Mrarthurking95/Sumobotmini/Link.txt

https://github.com/Mrarthurking95/Sumobotmini.git
