Mrarthurking95/Sumobotmini/Anexos/Costos.xlsx

Elemento | Referencia | Cantidad | Precio unidad | Precio total
Micro motor | HPCB 50:1/1.1 kg-cm/625rpm | 2 | $56000.00 | $112000.00
Sensor infrarrojo | Sensor Infrarrojo Sharp Análogo (4-30cm) | 3 | $25000.00 | $75000.00
Soporte | Soporte para micro motor | 2 | $15000.00 | $15000.00
Sensor Infrarrojo | Sensor Infrarrojo QRD1114 | 4 | $3200.00 | $12000.00
Rueda | Rueda Mini Sumo | 2 | $35000.00 | $35000.00
Batería | Batería Lipo | 1 | $51979.00 | $51979.00
Driver De Motor | Driver De Motor L293D | 1 | $4000.00 | $4000.00
Micro controlador | STM32F103C8T6 (Blue Pill) | 1 | $18500.00 | $18500.00
Módulo Wifi | Módulo Wifi - ESP8266 | 1 | $9000.00 | $9000.00
Regulador | AMS1117 | 1 | $2300.00 | $4600.00
Regulador | Lm7805 TO-220 | 1 | $1500.00 | $1500.00
Resistencia | Resistencias ¼ W | 11 | $20.00 | $220.00
Capacitores | Condensador electrolítico de montaje | 5 | $100.00 | $500.00
Diodo Zener | Diodo Zener DO-41 (DO-204AL) de 3.6V | 1 | $200.00 | $200.00
Bornera | Bornera 2 pines | 3 | $600.00 | $1800.00
Placa | Placa de cobre | 1 | $1500.00 | $1500.00
Pulsador | Pulsador NA, tipo Through-hole-mounting. | 1 | $200.00 | $200.00
Switch | Interruptor de encendido / apagado | 1 | $2000.00 | $2000.00
Costo total |  |  |  | $344999.00
