Mrarthurking95/Sumobotmini/PCB/Project Outputs for PCB_Project/pcbsumo.xls

Comment | Description | Designator | Footprint | LibRef | Quantity
BLUE PILL | DIP20 STM32F103C8T6 |  | DIP40 | BLUE PILL | 1
L293D | TB6612FNG |  | DIP16 | L293D | 1
BORNERA1X2 | Optoacoplador con fototransistor de salida y conexión a base. Voltaje de aislamiento de prueba 5300 VRMS, capacitancia entrada -salida < 0.5 pF. Empaque 6-DIP. | BAT7.4, MOT1, MOT2 | BORN1X2 | BORNERA1X2 | 3
Cap2 | Capacitor | C1, C2, C3, C4 | CAPR5-4X5 | Cap2 | 4
D Zener | Zener Diode | D1 | DIODE-0.7 | D Zener | 1
LM7805 | D39 IC REGULATOR 5VOLT LM7805 THT | P1 | TO-220A | LM7805 | 1
Pulsador2 |  | pul1 | PULSADOR | Pulsador2 | 1
Connector header 4P | Header, 4-Pin | QRD1114_1, QRD1114_2, QRD1114_3, QRD1114_4 | HEADER 1X4 | Connector header 4P | 4
Res1 | Resistor | R1, R2, R3, R4, R5, R6, R7, R8, R9, R10, R12 | AXIAL-0.3 | Res1 | 11
SW-PB | Switch | S1 | SPST-2 | SW-PB | 1
Connector header 3P | Header, 3-Pin | SHARP1, SHARP2, SHARP3 | HEADER 1X3 | Connector header 3P | 3
Mod regu 3.3 | Optoacoplador con fototransistor de salida y conexión a base. Voltaje de aislamiento de prueba 5300 VRMS, capacitancia entrada -salida < 0.5 pF. Empaque 6-DIP. | U1 | ASM1117 | ASM1117 | 1
