Mrarthurking95/Sumobotmini/Anexos/Schematic Prints.pdf

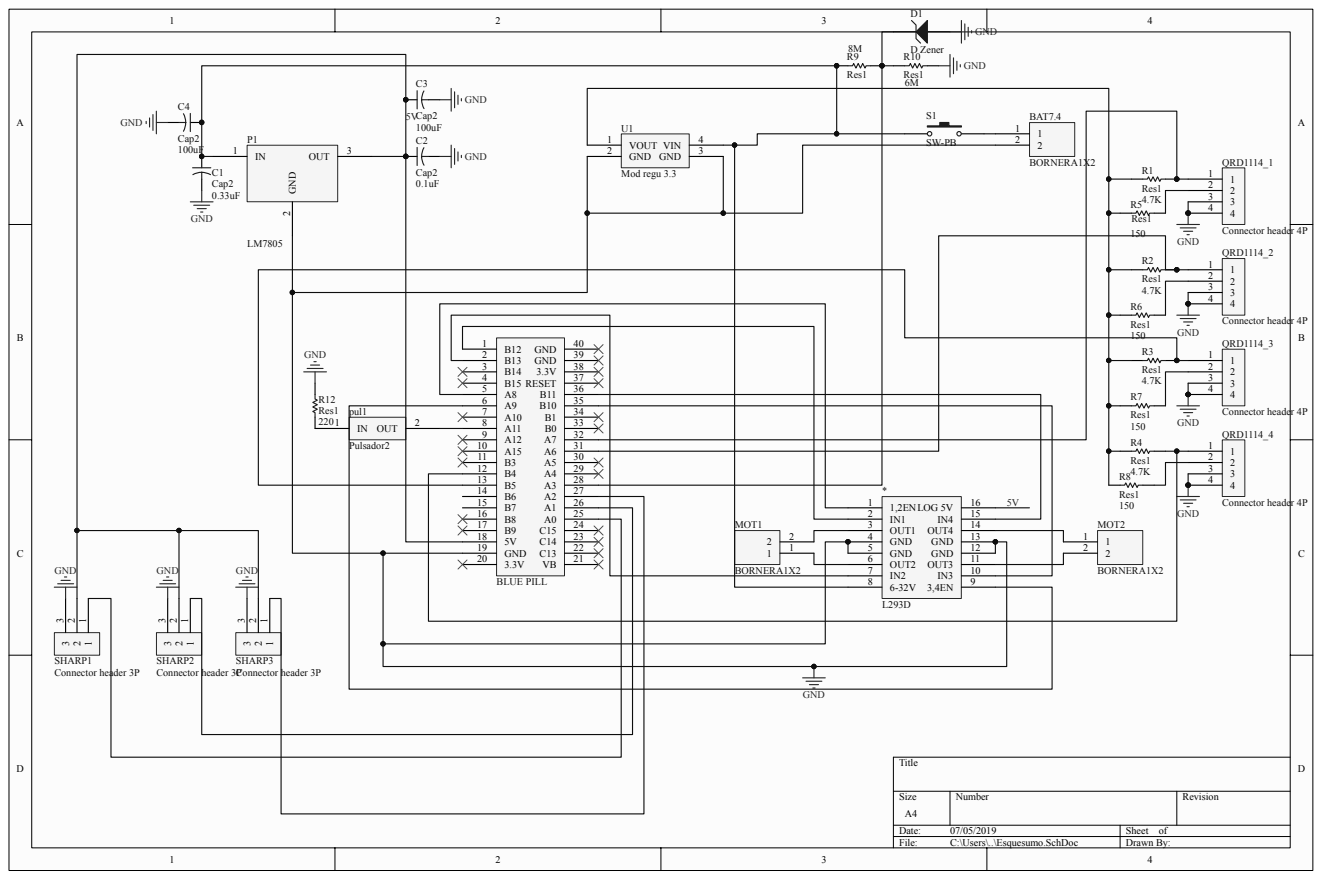
[picture p21: page 1]

8M D Zener R9

Size A4 | Number | Revision

Date: 07/05/2019 | Sheet of
File: C:\Users\..\Esquesumo.SchDoc | Drawn By:
