Mrarthurking95/Sumobotmini/(list of files, drawings)

Other design files:
PCB/Biblioteca/Biblioteca esquematica.SchLib
PCB/Biblioteca/Bibliotecahpta.PcbLib
PCB/Biblioteca/Esquesumo.SchDoc
PCB/PCB_Project.PrjPcb
PCB/pcbsumo.PcbDoc
