Mrarthurking95/Sumobotmini/Sumov1/Src/main.c

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

/* Includes ------------------------------------------------------------------*/
#include "main.h"

/* USER CODE BEGIN PD */
volatile uint16_t contMilis=0;
volatile uint16_t contAttack=0;//Tiempo de ataque
volatile uint16_t sharpizq;//Sensor ir sharp de frente
volatile uint16_t sharpfront;//Sensor ir sharp de frente
volatile uint16_t sharpder;//Sensor ir sharp de frente
volatile uint16_t battery;//Adc voltaje bateria
volatile uint8_t QRD1;
volatile uint8_t QRD2;
volatile uint8_t QRD3;
volatile uint8_t QRD4;
//volatile uint8_t tadcEN;
void direccion_process();//proceso direccion
void modo_process();//proceso modo
void piso_process();//proceso el piso
enum{//Estados motores
	   ADELANTE=0,
	   ATRAS,
	   IZQUIERDA,
	   DERECHA,
	   QUIETO,
	   DIRSTAT//Numero de Timers boton presionado
};
ST_MOT=ADELANTE;
enum{//Timers de estado
	TimATAQUE,
	TimREVERSA,
	TIMERS
};
ST_TIM=TimATAQUE;
enum{//Modo robot
	BUSQUEDA=0,
	ATAQUE,
	FREERUN,//Modo de camino random
	DESCANSO,
	ESTAT//Numero de estados
}
ST_MODO=DESCANSO;
/* USER CODE END PD */

ADC_HandleTypeDef hadc1;
DMA_HandleTypeDef hdma_adc1;
TIM_HandleTypeDef htim1;
TIM_HandleTypeDef htim2;
UART_HandleTypeDef huart1;
/* USER CODE BEGIN PV */
uint16_t alistarse=0;
uint8_t alistEN=0;
uint8_t TiemADC=0;
uint8_t atimEN=0;//Timer que define el tiempo que durara en la secuencia de ataque
volatile uint32_t adc_buf[4];
/* USER CODE END PV */

void SystemClock_Config(void);
static void MX_GPIO_Init(void);
static void MX_DMA_Init(void);
static void MX_TIM1_Init(void);
static void MX_TIM2_Init(void);
static void MX_ADC1_Init(void);
static void MX_USART1_UART_Init(void);
/**
  * @brief  The application entry point.
  * @retval int
  */
int main(void)
{
  /* MCU Configuration--------------------------------------------------------*/

  /* Reset of all peripherals, Initializes the Flash interface and the Systick. */
  HAL_Init();

  /* Configure the system clock */
  SystemClock_Config();

  /* Initialize all configured peripherals */
  MX_GPIO_Init();
  MX_DMA_Init();
  MX_TIM1_Init();
  MX_TIM2_Init();
  MX_ADC1_Init();
  MX_USART1_UART_Init();
  /* USER CODE BEGIN 2 */
  HAL_TIM_Base_Start_IT(&htim2);
  HAL_ADC_Start_DMA(&hadc1,(uint32_t*)adc_buf,4);
  HAL_ADC_Start_IT(&hadc1);
  HAL_TIM_PWM_Start(&htim1,TIM_CHANNEL_1);
  HAL_TIM_PWM_Start(&htim1,TIM_CHANNEL_2);
  __HAL_TIM_SET_COMPARE(&htim1,TIM_CHANNEL_1,3599);//100%
  __HAL_TIM_SET_COMPARE(&htim1,TIM_CHANNEL_2,3599);//100%
  /* USER CODE END 2 */

  /* Infinite loop */
  /* USER CODE BEGIN WHILE */
  while (1)
  {
    /* USER CODE END WHILE */

    /* USER CODE BEGIN 3 */
	  //Inicio cambio segundo
	  /*
	  HAL_ADC_Start(&hadc1);
	  HAL_ADC_PollForConversion(&hadc1,15);//15 ms muestreo
	  sharpfront=HAL_ADC_GetValue(&hadc1);
	  HAL_ADC_Stop(&hadc1);
	  */
	  //Adc para sensores
	  if(TiemADC>=10){
		  HAL_ADC_Start_IT(&hadc1);
		  sharpizq=adc_buf[0];
		  sharpfront=adc_buf[1];
		  sharpder=adc_buf[2];
		  battery=adc_buf[3];
		  TiemADC=0;
	  }else{
		//  tadcEN=1;
	  }
	  modo_process();
	  direccion_process();
  }
  /* USER CODE END 3 */
}
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
/* USER CODE BEGIN 4 */
void modo_process(){
	switch(ST_MODO){
	case BUSQUEDA:
		if(sharpizq<sharpfront && sharpfront>sharpder){ //Objeto en el frente mayor
		//	ST_MODO=ATAQUE;
			  ST_MOT=ADELANTE;
		}else if(sharpizq>sharpfront && sharpizq>sharpder){//Si hay un objeto en izquierda
		    ST_MOT=IZQUIERDA;
		}else if(sharpder>sharpfront && sharpder>sharpizq){
			ST_MOT=DERECHA;
		}
		alistarse=0;
//		ST_MOT=IZQUIERDA;
	break;
	case ATAQUE:
		atimEN=1;//attack timer enable
		ST_MOT=ADELANTE;//Modo ataque
		if(contAttack>=2500){
			atimEN=0;
			contAttack=0;
			ST_MOT=BUSQUEDA;
		}

	break;
	case FREERUN:
		  if(contMilis>=1000){//Programacion freerun
			  contMilis=0;
			  HAL_GPIO_TogglePin(GPIOC,GPIO_PIN_13);
			  if(ST_MOT==ADELANTE){
				  ST_MOT=ATRAS;
			  }
			  else if(ST_MOT==ATRAS){
				  ST_MOT=IZQUIERDA;
			  }
			  else if(ST_MOT==IZQUIERDA){
				  ST_MOT=DERECHA;
			  }
			  else if(ST_MOT==DERECHA){
				  ST_MOT=QUIETO;
			  }
			  else if(ST_MOT==QUIETO){
				  ST_MOT=ADELANTE;
			  }
			  contMilis=0;
		  } //Fin programacion freerun
	break;
	case DESCANSO://5 segundos antes de la competicion
		ST_MOT=QUIETO;
		if(alistarse>=5000){
			ST_MODO=BUSQUEDA;
		}
	break;
	}
}//Fin modos del carro
void piso_process(){
	QRD1=HAL_GPIO_ReadPin(GPIOB,QRD1_Pin);//QRD1
	QRD2=HAL_GPIO_ReadPin(GPIOB,QRD2_Pin);//QRD2
	QRD3=HAL_GPIO_ReadPin(GPIOB,QRD3_Pin);//QRD3
	QRD4=HAL_GPIO_ReadPin(GPIOB,QRD4_Pin);//QRD4
}//Fin proceso piso
void direccion_process(){
switch(ST_MOT){
	case ADELANTE:
		  HAL_GPIO_WritePin(GPIOB,IN1_Pin, GPIO_PIN_RESET);//	B12
		  HAL_GPIO_WritePin(GPIOB, IN2_Pin, GPIO_PIN_SET);//B13
		  HAL_GPIO_WritePin(GPIOB,IN3_Pin, GPIO_PIN_SET);//	B12
		  HAL_GPIO_WritePin(GPIOB, IN4_Pin, GPIO_PIN_RESET);//B13
	break;
	case ATRAS:
		  HAL_GPIO_WritePin(GPIOB,IN1_Pin, GPIO_PIN_SET);//	B12
		  HAL_GPIO_WritePin(GPIOB, IN2_Pin, GPIO_PIN_RESET);//B13
		  HAL_GPIO_WritePin(GPIOB,IN3_Pin, GPIO_PIN_RESET);//	B12
		  HAL_GPIO_WritePin(GPIOB, IN4_Pin, GPIO_PIN_SET);//B13
	break;
	case IZQUIERDA:
		  HAL_GPIO_WritePin(GPIOB,IN1_Pin, GPIO_PIN_SET);//	B12
		  HAL_GPIO_WritePin(GPIOB, IN2_Pin, GPIO_PIN_RESET);//B13
		  HAL_GPIO_WritePin(GPIOB,IN3_Pin, GPIO_PIN_SET);//	B10
		  HAL_GPIO_WritePin(GPIOB, IN4_Pin, GPIO_PIN_RESET);//B11
	break;
	case DERECHA:
		  HAL_GPIO_WritePin(GPIOB,IN1_Pin, GPIO_PIN_RESET);//	B12
		  HAL_GPIO_WritePin(GPIOB, IN2_Pin, GPIO_PIN_SET);//B13
		  HAL_GPIO_WritePin(GPIOB,IN3_Pin, GPIO_PIN_RESET);//	B10
		  HAL_GPIO_WritePin(GPIOB, IN4_Pin, GPIO_PIN_SET);//B11
	break;
	case QUIETO:
		  HAL_GPIO_WritePin(GPIOB,IN1_Pin, GPIO_PIN_RESET);//	B12
		  HAL_GPIO_WritePin(GPIOB, IN2_Pin, GPIO_PIN_RESET);//B13
		  HAL_GPIO_WritePin(GPIOB,IN3_Pin, GPIO_PIN_RESET);//	B12
		  HAL_GPIO_WritePin(GPIOB, IN4_Pin, GPIO_PIN_RESET);//B13
	break;
}
}
void HAL_ADC_ConvCpltCallback(ADC_HandleTypeDef* hadc){//Interrupcion adc
	uint32_t val[4];
	if(hadc->Instance==ADC1){
		val[0]=adc_buf[0];
		val[1]=adc_buf[1];
		val[2]=adc_buf[2];
		val[3]=adc_buf[3];
	}
}
//Contador milis
void HAL_TIM_PeriodElapsedCallback(TIM_HandleTypeDef *htim){
	if(htim->Instance == TIM2){
		if(atimEN==1){
			contAttack++;
		}
		//if(tadcEN==1){

			if(TiemADC>=10){
				//TiemADC=0;
			}else{
			TiemADC++;
			}
		//}
		if(contMilis<=1000){
		contMilis++;
		if(ST_MODO==DESCANSO){
			if(alistarse<=5000){
				alistarse++;
			}else{
				ST_MODO=BUSQUEDA;
			}

		}
		}else{
			contMilis=0;
		}
		//if (contMilis>=1000){
			//contMilis=0;
	//	HAL_GPIO_TogglePin(GPIOC,GPIO_PIN_13);
		//}
	}
}
/* USER CODE END 4 */
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
