Mrarthurking95/Sumobotmini/Sumov1/Sumov1.ioc

Mcu.UserName=STM32F103C8Tx
PA0-WKUP.Signal=ADCx_IN0
PA1.Signal=ADCx_IN1
PA11.GPIO_Label=PULSADOR
PA11.Signal=GPIO_Input
PA13.Signal=SYS_JTMS-SWDIO
PA14.Signal=SYS_JTCK-SWCLK
PA2.Signal=ADCx_IN2
PA3.Signal=ADCx_IN3
PA6.GPIO_Label=QRD3
PA6.Signal=GPIO_Output
PA7.GPIO_Label=QRD4
PA7.Signal=GPIO_Output
PA8.Signal=S_TIM1_CH1
PA9.Signal=S_TIM1_CH2
PB10.GPIO_Label=IN3
PB10.Signal=GPIO_Output
PB11.GPIO_Label=IN4
PB11.Signal=GPIO_Output
PB12.GPIO_Label=IN1
PB12.Signal=GPIO_Output
PB13.GPIO_Label=IN2
PB13.Signal=GPIO_Output
PB4.GPIO_Label=QRD1
PB4.Signal=GPIO_Input
PB5.GPIO_Label=QRD2
PB5.Signal=GPIO_Input
PB6.Signal=USART1_TX
PB7.Signal=USART1_RX
PC13-TAMPER-RTC.Signal=GPIO_Output
PD0-OSC_IN.Signal=RCC_OSC_IN
PD1-OSC_OUT.Signal=RCC_OSC_OUT
