Mrarthurking95/Sumobotmini/(notices)

Notices in the files:
Sumov1/Src/main.c:
COPYRIGHT(c) 2019 STMicroelectronics
(C) COPYRIGHT STMicroelectronics *****END OF FILE
